thepalbi/dibu-architecture/docs/architecture.pdf

## DiBU: Digilent Based Unit

Pablo Balbi, Rodrigo Parra

Mayo 2023

1

## Índice

1. Introducción | 3
2. Registros | 4
3. Memoria | 4
4. Instrucciones | 5
5. Pseudo-instrucciones | 9
6. Llamadas a sub-rutinas | 10
7. Unidad de control | 11
8. Testing y validación | 13
9. Referencias | 13

2

## 1. Introducción

Este documento contiene la descripción del ISA¹ de la máquina DiBU , en conjunto con sus decisiones de diseño y detalles de implementación. A lo largo del documento se referencia múltiples partes del código fuente, las cuales se encuentran documentadas mediante comentarios. Por ello, este documento no debe ser leído aislado del código fuente, sino en conjunto con el mismo.
La máquina DiBU cuenta con las siguientes prestaciones:

Ocho registros de propósito general, cada uno de 8 bits de ancho.

Soporte para llamadas a función, con un límite de 8 llamadas anidadas.

Un puerto de entrada y otro de salida de datos, cada uno con 4 bits.

Una memoria de datos de 1kB, con direccionamiento a byte.

Instrucciones de tamaño fijo de 16 bits, con una memoria de código de 1kB.

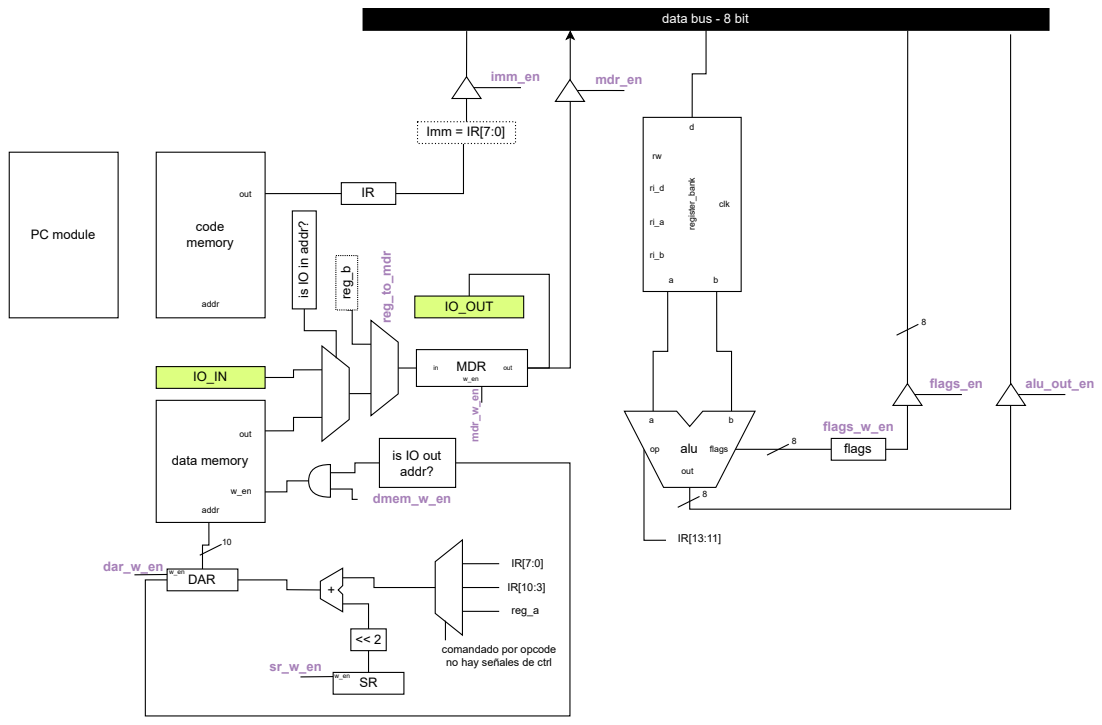
[picture p2: figure]
clk; b register_bank; alu flags; out; data bus - 8 bit; flags; flags_w_en; flags_en; alu_out_en; Imm = IR[7:0]; imm_en; code memory; addr; MDR; DAR; data memory; reg_a; comandado por opcode no hay señales de ctrl; PC module; dmem_w_en; is IO out addr?; IO_OUT; reg_to_mdr; is IO in addr?; mdr_en; reg_b; dar_w_en w_en; w_enmdr_w_en

Figura 1: Diagrama del datapath de la máquina.

1
Instruction Set Architecture.

3

### 1.1. Estructura del documento

Este documento primero presenta algunas características generales de la máquina DiBU . La sección 2 y 3 detalla los diferentes registros expuestos al programador y la organización tanto de la memoria de código como datos.
Luego, la sección de 4 primero describe los diferentes formatos de instrucción mediante los cuales se codifican las instrucciones en la memoria de código. También se presenta una tabla de referencia con todas las instrucciones soportadas y la acción que cada una realiza. Se detalla como se codifica cada tipo de instrucción junto con sus operandos. Por último, la sección 5 detalla la implementación de una serie de instrucciones “virtuales”, que facilitan la codificación de programas.
A continuación, una serie de secciones explican algunos detalles de funcionamiento de la máquina: cómo se implementan los llamados a función, en la sección 6 y el funcionamiento interno de la unidad de control en 7.
Finalmente, la sección 8 relata el enfoque utilizado para la validación del funcionamiento de la máquina.

## 2. Registros

La máquina DiBU expone al programador 8 registros de propósito general, cada uno de 8 bits. Estos pueden ser usados para operaciones lógico-aritméticas, accesos a memoria y entrada / salida. Además, existen dos registros de propósito específico: el registro de segmento, SR, usado para definir la porción de memoria direccionable, y el PC, registro de 9 bits que indica la instrucción siendo ejecutada.

Registro | Tamaño (bits)

Accesible a
programador

Descripción

Rx | x ∈ {0, .., 7} | 8 | Si | Registro de propósito general
SR | 8 | Si | Registro de segmento
PC | 9 | No | Registro contador de programa

## 3. Memoria

Una máquina DiBU tiene dos memorias de 1kB, una de datos y una de programa. Para el caso de la memoria de instrucciones, las direcciones tendrán un tamaño de 9 bits, ya que las instrucciones tiene un tamaño fijo de 16 bits. En el caso de la memoria de datos, las direcciones tendrán un tamaño de 10 bits, con direccionamiento a byte.
Debido a que los registros de propósito general son de 8 bits, el modo de direccionamiento indirecto no podrá direccionar a la totalidad de la memoria de datos. Para ello, se tendrá un registro adicional llamado SR o segment register. De esta manera, dada un dirección local Alocal a un segmento, la dirección física de memoria Af isica se calcula como:
Af isica = SR ≪ 2 + Alocal | (1)

Esto permite direccionar cualquier porción de 255 palabras de memoria, partiendo de una dirección determinada por el registro de segmento.

4

Cabe de estar que al acceder a los registros de entrada y salida es importante que el registro SR esté configurado para acceder a la sección más alta de la memoria.

## 4. Instrucciones

En DiBU las instrucciones tienen un tamaño fijo de 16 bits, igual que la palabra direccionable dentro de la memoria de instrucciones. Gracias a esto no se deben realizar verificaciones de la posición de memoria usada en las instrucciones de salto, o llamada a sub-rutinas.
Los formatos de instrucción utilizan de manera fija los 5 bits más significativos para determinar el opcode, y el resto para operandos. En total, DiBU soporta 4 formatos de instrucción definidos en 4.1.
La asignación de códigos de operación no será secuencial, sino que seguirá un árbol de asignaciones siempre y cuando sea posible. Esto nos permite para el caso de las instrucciones lógico-aritméticas diferenciarlas del resto con los primeros 2 bit (Opcode[4:3]), y utilizar el resto como bits de código de función de la ALU (Opcode[2:0]).

### 4.1. Formatos

La arquitectura DiBU cuenta con 4 formatos de instrucción los cuales están pensados para minimizar la cantidad de señales de control necesarias en el datapath.

### 4.1.1. Formato A

0 | 0
15 | 14 | 13 | 12 | 11 | 10 | 9 | 8 | 7 | 6 | 5 | 4 | 3 | 2 | 1 | 0
Opcode[4:0] | ra[2:0] | rb[2:0] | rc[2:0]

### 4.1.2. Formato B

15 | 14 | 13 | 12 | 11 | 10 | 9 | 8 | 7 | 6 | 5 | 4 | 3 | 2 | 1 | 0
Opcode | ra[2:0] | Imm[7:0]

### 4.1.3. Formato C

15 | 14 | 13 | 12 | 11 | 10 | 9 | 8 | 7 | 6 | 5 | 4 | 3 | 2 | 1 | 0
Opcode | Imm[7:0] | rc[2:0]

### 4.1.4. Formato D

5

0 | 0
15 | 14 | 13 | 12 | 11 | 10 | 9 | 8 | 7 | 6 | 5 | 4 | 3 | 2 | 1 | 0
| | Opcode | | | | | | | | | Addr[8:0]

### 4.2. Tabla de referencia

La siguiente tabla muestra un resumen del ISA soportado por DiBU , junto con una descripción semántica la o las operaciones que lleva a cabo cada instrucción. Al interpretar los operandos, tener en cuenta lo siguiente:

Rx hace referencia a un registro de propósito general

Imm hace referencia a un valor inmediato de 8 bit

M hace referencia a una dirección de memoria de datos de 10 bit, y [⋆] a la palabra en memoria referenciada por la dirección ⋆

Label hace referencia a una etiqueta en el código fuente ensamblador, la cual será traducida a una dirección de memoria de código de 9 bit por el programa ensamblador

Instrucción | Acción | Formato | Opcode
ssr Rx | SR ← Rx | A | 01100
mov Rx imm | Rx ← Imm | B | 01111
mov Rx Ry | Rx ← Ry | A | 00111
movf Rx | Rx ← Flags | A | 01011
load Rx [M] | Rx ← [SR ≪ 2 + M] | B | 10000
load Rx [Ry] | Rx ← [SR ≪ 2 + Rx] | A | 10010
str [Rx] Ry | [SR ≪ 2 + Rx] ← Ry | A | 10011
str [M] Rx | [SR ≪ 2 + M] ← Rx | C | 10001
add Ra Rb Rc | Ra = Rb + Rc | A | 00000
sub Ra Rb Rc | Ra = Rb − Rc | A | 00001
and Ra Rb Rc | Ra = Rb ∧ Rc | A | 00010
or Ra Rb Rc | Ra = Rb ∨ Rc | A | 00011
lsl Ra Rb Rc | Ra = Rb ≪ Rc | A | 00100
lsr Ra Rb Rc | Ra = Rb ≫ Rc | A | 00101
not Ra Rb | Ra = ¬Rb | A | 00110
cmp Ra Rb | Flags ← Ra − Rb | A | 00111
addi Ra Imm | Ra = Ra + Imm | A | Pseudo ins
rnd Ra | Ra = Rand(Ra) | A | 11110
jmp Label | P C ← Imm | D | 11000
je Label | if Z=1 then P C ← Imm else PC++ | D | 11001
jne Label | if Z=0 then P C ← Imm else PC++ | D | 11010
jn Label | if N=1 then P C ← Imm else PC++ | D | 11011
call Label | Ver detalle debajo | D | 11100
ret | Ver detalle debajo | D | 11101
halt² | P C ← 111111111 | D | 11111

6

Para las dos instrucciones de llamadas a subrutina, se describe en detalle su funcionamiento en la sección 6.

### 4.3. Codificación de operaciones lógico-aritméticas

Las operaciones aritméticas y lógicas de la forma c = a ⋆ b, usan el formato de instrucción A, donde un registro es usado para guardar el resultado de la operación, y los otros dos como operandos.
Como fue mencionado en 4, los opcodes no son asignados secuencialmente para estas instrucciones, sino que siguen el siguiente formato: los dos bit más significativos Opcode[4:3] quedan fijos en 0, mientras que los restantes Opcode[2:0] se asignan partiendo de 0, uno por operación soportada por la ALU. Esto permite, en el datapath, rutear de manera directa estos bits desde el registro de instrucciones IR, a los puertos de código de función de la ALU.
0 | 0 | 0 | 0
15 | 14 | 13 | 12 | 11 | 10 | 9 | 8 | 7 | 6 | 5 | 4 | 3 | 2 | 1 | 0
Opcode[2:0] | ra[2:0] | rb[2:0] | rc[2:0]
| | | add=0 sub=1 and=2 or=3 lsl=4 lsr=5 | | | dest | | | | | src1 | | | src2

Las operaciones aritméticas y lógicas de la forma c = ⋆a, usan el mismo formato de instrucción, pero ignorando el primer registro en el formato. De esta forma, utiliza rb como único operando, y ra como registro de destino. Un caso particular de estas instrucciones es mov ra rb, cuya ejecución cumple el mismo flujo que cualquier operación lógico aritmética, pero utilizando la ALU con una función de identidad.

0 | 0 | 0 | 0 | 0 | 0 | 0
0 | 1 | 2 | 3 | 4 | 5 | 6 | 7 | 8 | 9 | 10 | 11 | 12 | 13 | 14 | 15
Opcode[2:0] | ra[2:0] | rb[2:0]
| | | not=6 identity=7 | | | dest | | | | | src

Luego, algunas instrucciones operan con único registro y un valor inmediato, permitiendo operaciones como incrementar asignar un valor inmediato a un registro, mov ra 0xde. Estas utilizan el formato B.

2
Instrucción virtual, solamente usada por los test benches para detectar que finalizó la ejecución de un programa.

7

0 | 1
15 | 14 | 13 | 12 | 11 | 10 | 9 | 8 | 7 | 6 | 5 | 4 | 3 | 2 | 1 | 0
Opcode[2:0] | ra[2:0] | Imm[7:0]
mov = 111 | reg | valor

La instrucción cmp (compare) presenta un caso particular. Los dos bits más significativos del op-code la diferencian de las instrucciones de operaciones entre registros, pero los tres restantes tiene el valor del código de función de la ALU correspondiente a la substracción.

0 | 1 | 0 | 0 | 0 | 0 | 0
15 | 14 | 13 | 12 | 11 | 10 | 9 | 8 | 7 | 6 | 5 | 4 | 3 | 2 | 1 | 0
Opcode[2:0] | rb[2:0] | rc[2:0]

cmp = 001

Por último, hay una serie de instrucciones que realizan una operación sobre un registro en particular. Las mismas siguen usando el formato A, pero solo teniendo en cuenta el último registro del formato.

0 | 1 | 0 | 0 | 0 | 0 | 0 | 0 | 0 | 0
15 | 14 | 13 | 12 | 11 | 10 | 9 | 8 | 7 | 6 | 5 | 4 | 3 | 2 | 1 | 0
Opcode[2:0] | ra[2:0]
movf = 011 | reg

### 4.4. Codificación de operaciones de accesso a memoria

DiBU es una arquitectura load-store, donde solo las instrucciones de load y store acceden a memoria, y todas las operaciones lógico-aritméticas operan entre registros. La máquina implemente 3 modos de direccionamiento a memoria:

Directo: Las instrucciones contienen la dirección de memoria con la cual leer / escribir.

Indirecto a registro: La dirección de memoria con la cual leer / escribir es leída del valor de un registro.

Las instrucciones de load y store con direccionamiento directo se codifican de la siguiente manera:

1 | 0
15 | 14 | 13 | 12 | 11 | 10 | 9 | 8 | 7 | 6 | 5 | 4 | 3 | 2 | 1 | 0
Opcode[2:0] | ra[2:0] | Imm[7:0]
load = 000 | dest reg | addr

8

1 | 0
15 | 14 | 13 | 12 | 11 | 10 | 9 | 8 | 7 | 6 | 5 | 4 | 3 | 2 | 1 | 0
Opcode[2:0] | Imm[7:0] | rc[2:0]
str = 001 | src addr

Por otro lado, en el caso de direccionamiento indirecto, la codificación es la siguiente:

1 | 0 | 0 | 0 | 0 | 0 | 0
0 | 1 | 2 | 3 | 4 | 5 | 6 | 7 | 8 | 9 | 10 | 11 | 12 | 13 | 14 | 15
Opcode[2:0] | ra[2:0] | rb[2:0]
load = 010 | dest | src addr
1 | 0 | 0 | 0 | 0 | 0 | 0
15 | 14 | 13 | 12 | 11 | 10 | 9 | 8 | 7 | 6 | 5 | 4 | 3 | 2 | 1 | 0
Opcode[2:0] | rb[2:0] | rc[2:0]
| | | str = 011 | | | | | | | | dst addr | | | src

### 4.5. Codificación de operaciones de control de flujo

DiBU provee tres tipos de instrucciones para controlar el flujo de ejecución de un programa: saltos incondicionales, saltos condicionales y llamadas a sub-rutinas, todas codificadas con el mismo formato de instrucción.

1 | 1 | 0 | 0
15 | 14 | 13 | 12 | 11 | 10 | 9 | 8 | 7 | 6 | 5 | 4 | 3 | 2 | 1 | 0
Opcode[2:0] | target[8:0]

jmp = 000
| | | je = 001
jne = 010
| | | jn = 011
call = 100

jump / call address

## 5. Pseudo-instrucciones

DiBU soporta pseudo-instrucciones, instrucciones que no se encuentran implementadas en las estructuras de micro-control de la máquina, sino que son traducidas en tiempo de compilación a una o más instrucciones “reales”. Un ejemplo de estas es addi ri imm, instrucción que permite sumar un valor inmediato a un registro. Este soporte fue agregado una vez que casi la totalidad de la máquina este implementada, y surgió de la necesidad de describir ciertas operaciones comunes, como incrementar el valor de un registro usado como contador, de manera más concisa. Por esto, el soporte para estas pseudo-instrucciones fue implementado dentro del programa ensamblador, y usando como registro temporal de ser necesario r7. La implementación de esta funcionalidad se encuentra dentro de parser.py. (https://github.com/thepalbi/dibu-architecture/blob/main/dibuparser/parser.py#L176)

9

## 6. Llamadas a sub-rutinas

En base al requerimiento de que la arquitectura debe soportar al menos 5 llamadas a función anidadas se optó por utilizar una serie de 8 registros para almacenar los PC a medida que las llamadas se ejecuten. Cabe destacar que debido a que el contenido de estos registros es de 9 bits, no podían ser implementados en un stack en la memoria de datos. Esta serie de registros serán indexados mediante otro registro de 3 bits que se incrementará y decrementará en la medida en que se realicen llamados a funciones. A su vez, estos registros serán utilizados como PC, por lo que el PC activo se incrementará en la medida en que se encuentre dentro de esa función.

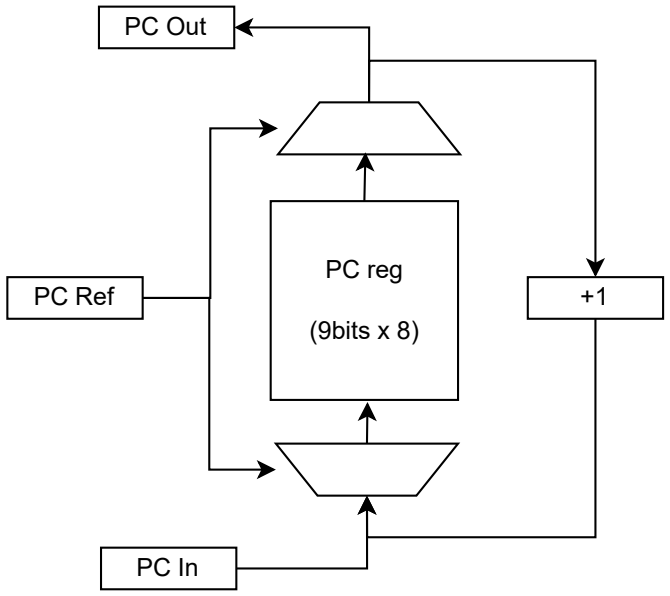
[picture p3: figure]
PC reg; (9bits x 8); PC Ref; PC Out

El siguiente pseudocódigo explica que ocurre en DiBU cuando se ejecuta una instrucción de call atajar penal:

Require: AP ← dirección de memoria atajar penal
Require: RP C apunta al P C activo, con RP C ∈ {0, ..., 7} ∧ RP C < 7 Require: MP C banco de 8 registros de 9 bit
M[RP C] ← M[RP C] + 1
RP C ← RP C + 1
M[RP C] ← AP

ReiniciarCicloDeEjecucion

Considerando el psuedo-código, en un ciclo de fetch, la instrucción a leer de memoria de código es Mcode[MP C[RP C]], siendo Mcode la memoria de código.
Luego, este otro pseudocódigo explica que ocurre en DiBU cuando se ejecuta una instrucción de ret:

Require: RP C apunta al P C activo, con RP C ∈ {0, ..., 7} ∧ RP C > 0

10

Require: MP C banco de 8 registros de 9 bit

RP C ← RP C − 1

ReiniciarCicloDeEjecucion

## 7. Unidad de control

La máquina DiBU cuenta con una organización micro-controlada, donde cada instrucción se implementa cono una serie de micro-instrucciones, que controlan las diferentes señales en el datapath, cuyo diagrama se muestra en la figura 1. Las micro-instrucciones, almacenadas en una memoria ROM dentro de la unidad de control como se puede ver en la figura 2, controlan todo el ciclo de ejecución de la máquina: los ciclos fetch, decode y execute, donde se lee una instrucción de memoria, se decodifica y ejecuta, y las acciones necesarias para ejecutar cada

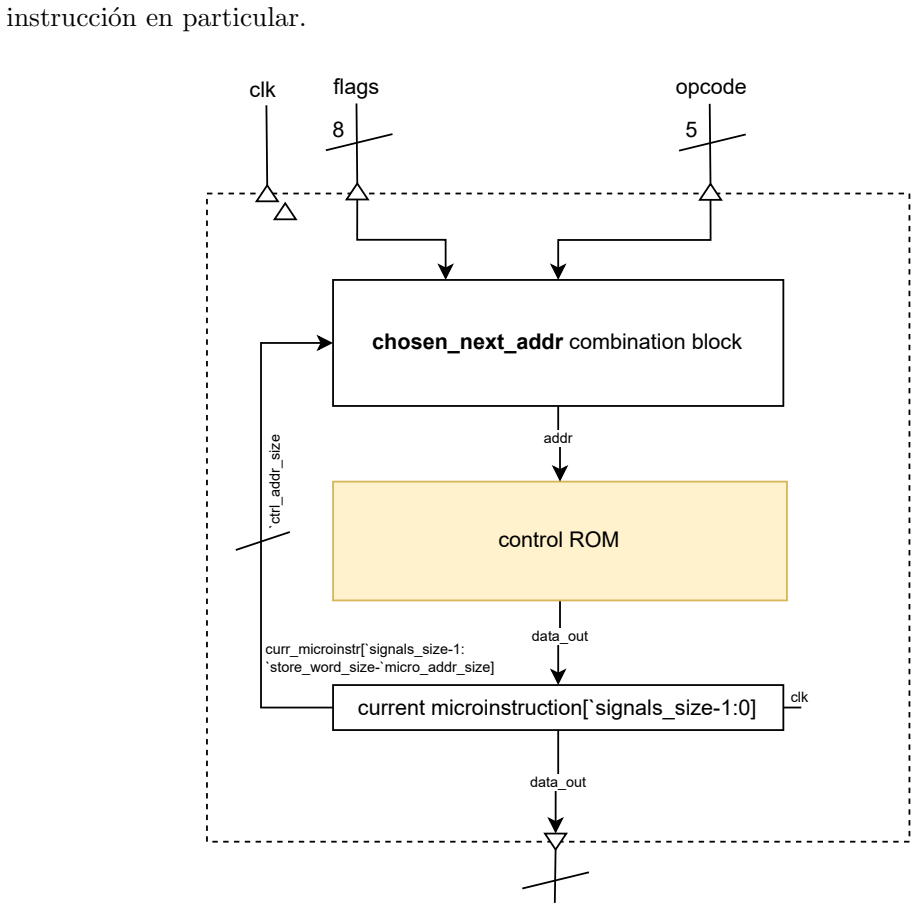
[picture p4: figure]
instrucción en particular.; clk; flags; opcode; `ctrl_addr_size; curr_microinstr[`signals_size-1: `store_word_size-`micro_addr_size]; data_out; control ROM; current microinstruction[`signals_size-1:0]; addr; chosen_next_addr combination block

Figura 2: Diagrama de la unidad de control.

El programa denotado por todas las micro-instrucciones disponibles en la máquina, y el orden en que estas son ejecutadas, puede ser interpretado como una máquina de estados finita (FSM, o finite state machine). La figura 4 muestra una porción de esta máquina de estados, y las señales involucradas en cada estado. Cada estado, que se corresponde con una micro-instrucción, indica cual es el siguiente estado a ser ejecutado, a excepción de un caso

11 particular. Este último, al que se refiere como estado de decisión, decide la siguiente micro-instrucción a ser ejecutada a partir de el código de operación de la instrucción actual, y los flags provenientes de la ALU. La totalidad de la lógica que decide el siguiente estado se encuentra contenida en el primer bloque combinacional, etiquetado como “chosen next addr combination block” en la figura 2. También se puede apreciar en la figura 3 que cada micro-instrucción codifica todas las señales del datapath (signals), la dirección en la memoria ROM de la siguiente micro-instrucción a ejecutar, o un bit especial, que indica que el estado actual es el estado de decisión.
Debido a que la codificación de la unidad de control en Verilog requería codificar además, el contenido de la memoria ROM, se optó por implementar una herramienta que genera de manera automática las micro-instrucciones codificadas en la manera que se representan en la memoria, y ciertas porciones del código del datapath (mapping entre la salida de la unidad de control y las señales individuales). El código fuente de esta herramienta se encuentra en microprogram.py. (https://github.com/thepalbi/dibu-architecture/blob/main/dibu/microprogram.py#L14)
next addr | signals

is decision state?

`store_word_size - | 1 | 0
`micro_addr_size - 1
`micro_addr_size | `signals_size

`store_word_size-1

Figura 3: Formato de micro-instrucción.

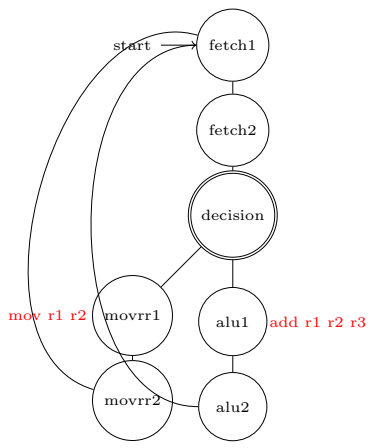
[picture p5: figure]
start; fetch1; fetch2; decision; mov r1 r2; movrr1; movrr2; alu1; add r1 r2 r3; alu2

Estado | Señales
fetch1 | MarWEn, PCWEn
fetch2 | IRWEn
movrr1 | ∅
movrr2 | RegRW, AluOutEn
alu1 | ∅
alu2 | FlagsWEn, RegRW, AluOutEn

Figura 4: Ejemplo de componente de la máquina de estados finita denotado por el programa de micro-instrucciones. La parte representada corresponde a la ejecución de dos intrucciones que operan sobre registros.

12

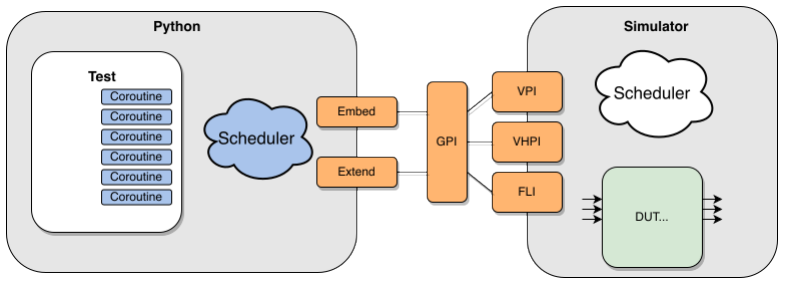
[picture p6: figure]

Figura 5: Descripción de alto nivel del funcionamineto de Cocotb, framework utilizado para el desarrollo de los test-benches de cada componente.

## 8. Testing y validación

Para el desarrollo de test-benches de los componentes se optó por utilizar un enfoque diferente a desarrollarlos en Verilog, debido a que el desarrollo es más complejo y más difícil de automatizar. Para ello, se utilizó el framework Cocotb³
. Cocotb es una biblioteca de Python que permite escribir test-benches de componentes de hardware programasdos en un lenguaje de descripción de hardware, como Verilog. Los tests desarrollados con esta herramienta siguen un enfoque de co-rutinas. Este consiste en interpretar los tests como dos hilos de ejecución, uno donde ocurren las validaciones, y otro que simula el funcionamiento de la unidad de hardware bajo validación (DUT). Durante la ejecución de una de estas pruebas, el control fluye entre el hilo validador, y el simulador, siguiendo ciertas primitivas que le indican al orquestador por cuánto tiempo ejecutar la simulación. La figura 5 muestra un diagrama de como estos hilos están conectados entre si.
En nuestra máquina, estos tests se encuentran en rtl tests. (https://github.com/thepalbi/dibu-architecture/tree/main/rtl_tests)

## 9. Referencias

Microprocesador OrgaSmall (https://github.com/fokerman/microOrgaSmall)

RISC-V (https://riscv.org/technical/specifications/)

3
https://www.cocotb.org/

13
