thepalbi/dibu-architecture/rtl/register.v

`timescale 1ns / 1ps
//////////////////////////////////////////////////////////////////////////////////
// Company: 
// Engineer: 
// 
// Create Date: 06/12/2023 10:06:50 PM
// Design Name: 
// Module Name: register
// Project Name: 
// Target Devices: 
// Tool Versions: 
// Description: 
// 
// Dependencies: 
// 
// Revision:
// Revision 0.01 - File Created
// Additional Comments:
// 
//////////////////////////////////////////////////////////////////////////////////


module register #(parameter width=8) (clk, rst, w_en, d_in, d_out);
    input clk, rst;
    // w_en: write enable
    input w_en;
    // d_in: data in, will be written in next posedge when w_en high
    input [width-1:0] d_in;

    // d_out: data out
    output reg [width-1:0] d_out;

    initial d_out <= 0;

    always @ (posedge clk) begin
        if (rst)
            d_out <= 'd0;
        else if (w_en)
            d_out <= d_in;
    end

endmodule
