thepalbi/dibu-architecture/(commit log)

2023-06-02 simple assembler code idea
2023-06-04 using assembler comments
2023-06-09 timing issue in test
    [test_alu.v]
2023-06-12 Usando cocotb para test benches
2023-07-05 listo para sintetizar
